fpt/esp-bt-audio/main/esp-bt-audio.kicad_pcb

## KiCad design main/esp-bt-audio.kicad_pcb (2026-11-05)

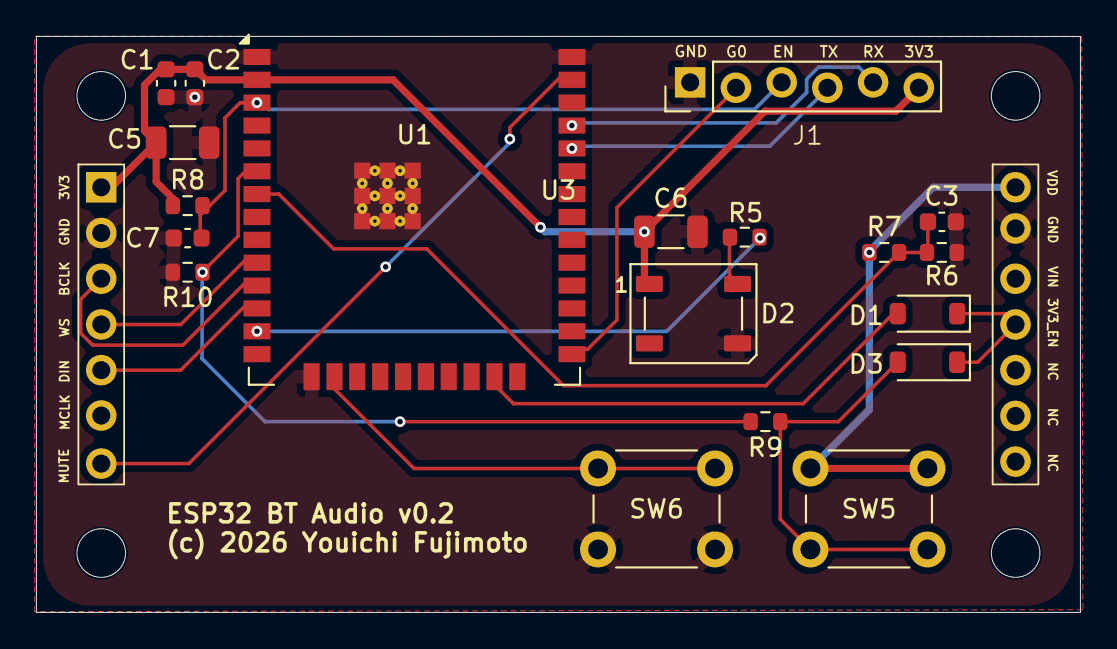
[picture p1: board esp-bt-audio.kicad_pcb from above]

Board: 2 copper layers, 58.0 x 32.0 mm, 20 parts (0 on the bottom side), 19 nets.

Parts:
C1: 10u; C_0603_1608Metric
C2, C3: 100n; C_0603_1608Metric
C5, C6: 100u; C_1206_3216Metric
C7: 1u; C_0603_1608Metric
D1, D3: 1N4148W; D_SOD-123
D2: WS2812B-V6; LED_WS2812B_PLCC4_5.0x5.0mm_P3.2mm
J1: ESPWriterJig; ESP32-Downloader_Pins
R5: 220; R_0603_1608Metric
R6, R7, R10: 100k; R_0603_1608Metric
R8: 10k; R_0603_1608Metric
R9: 22k; R_0603_1608Metric
SW5: SW_PWR1; SW_PUSH_6mm
SW6: SW_BT1; SW_PUSH_6mm
U1: ESP32-WROOM-32E
U3: github.com_fpt-I2C-Power_Module

Connections:
+3V3: C1.1, C2.1, C5.1, C6.1, D2.1 (VDD), J1.6 (3V3), R8.1, U1.2 (VDD), U3.1 (3V3)
/3V3_EN: D1.1 (K), D3.1 (K), U3.11 (3V3_EN)
/BAT_SENSE: C3.1, R6.1, R7.2, U1.7 (IO35)
/BCLK: U1.11 (IO26), U3.3 (BCLK)
/BOOT: J1.2 (G0), U1.25 (IO0)
/BTN_A1: SW6.1, U1.16 (IO13)
/DATA: U1.12 (IO27), U3.5 (DIN)
/EN: C7.1, J1.3 (EN), R8.2, U1.3 (EN)
/ESP_RX: J1.4 (TX), U1.34 (RXD0/IO3)
/ESP_TX: J1.5 (RX), U1.35 (TXD0/IO1)
/PWR_BTN: R9.2, R10.1, U1.6 (IO34)
/PWR_EN: D1.2 (A), U1.23 (IO15)
/RGB_LED: R5.1, U1.13 (IO14)
/SHUTDOWN: U1.37 (IO23), U3.7 (MUTE)
/WS: U1.10 (IO25), U3.4 (WS)
GND: C1.2, C2.2, C3.2, C5.2, C6.2, C7.2, D2.3 (VSS), J1.1 (GND), R6.2, R10.2, SW6.2, U1.1 (GND), U1.15 (GND), U1.38 (GND), U1.39 (GND), U3.2 (GND), U3.13 (GND)
unnamed: D2.4 (DIN), R5.2
unnamed: D3.2 (A), R9.1, SW5.2
VDD: R7.1, SW5.1, U3.14 (VDD)
