fpt/esp-bt-audio/i2s/i2s-power.kicad_pcb

## KiCad design i2s/i2s-power.kicad_pcb (2026-11-04)

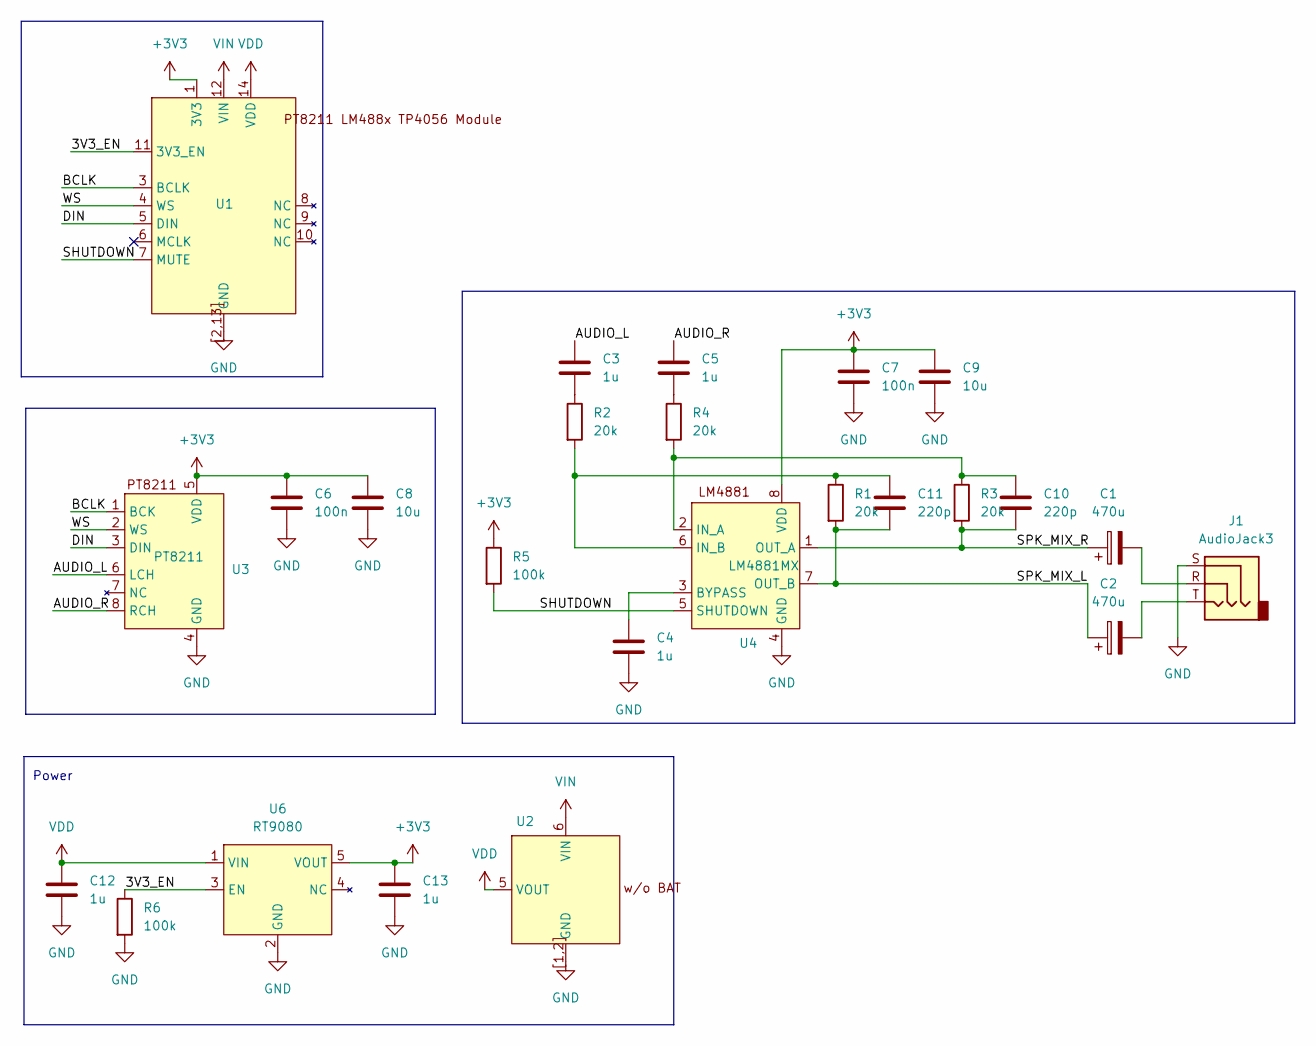
[picture p2: schematic i2s-power.kicad_sch]

Parts:
C1, C2: 470u; CP_Radial_D8.0mm_P3.50mm
C3, C4, C5, C12, C13: 1u; C_0603_1608Metric
C6, C7: 100n; C_0603_1608Metric
C8, C9: 10u; C_0603_1608Metric
C10, C11: 220p; C_0603_1608Metric
J1: AudioJack3; Jack_3.5mm_Switronic_ST-005-G_THT_Horizontal
R1, R2, R3, R4: 20k; R_0603_1608Metric
R5, R6: 100k; R_0603_1608Metric
U1: github.com_fpt-I2C-Power_Module
U2: GENERIC_TP4056_Module_wo_bat
U3: PT8211; SOP-8_3.76x4.96mm_P1.27mm; LCSC C92004
U4: LM4881MX; SO-8_3.9x4.9mm_P1.27mm
U6: RT9080; TSOT-23-5

Connections:
+3V3: C6.1, C7.1, C8.1, C9.1, C13.1, R5.1, U1.1 (3V3), U3.5 (VDD), U4.8 (VDD), U6.5 (VOUT)
/3V3_EN: R6.1, U1.11 (3V3_EN), U6.3 (EN)
/AUDIO_L: C3.1, U3.6 (LCH)
/AUDIO_R: C5.1, U3.8 (RCH)
/BCLK: U1.3 (BCLK), U3.1 (BCK)
/DIN: U1.5 (DIN), U3.3 (DIN)
/SHUTDOWN: R5.2, U1.7 (MUTE), U4.5 (SHUTDOWN)
/SPK_MIX_L: C2.1, C11.2, R1.2, U4.7 (OUT_B)
/SPK_MIX_R: C1.1, C10.2, R3.2, U4.1 (OUT_A)
/WS: U1.4 (WS), U3.2 (WS)
GND: C4.2, C6.2, C7.2, C8.2, C9.2, C12.2, C13.2, J1.S, R6.2, U1.2 (GND), U1.13 (GND), U1.[2,13] (GND), U2.1 (GND), U2.2 (GND), U2.[1,2] (GND), U3.4 (GND), U4.4 (GND), U6.2 (GND)
unnamed: C1.2, J1.R
unnamed: C2.2, J1.T
unnamed: C3.2, R2.1
unnamed: C5.2, R4.1
unnamed: C4.1, U4.3 (BYPASS)
unnamed: C10.1, R3.1, R4.2, U4.2 (IN_A)
unnamed: C11.1, R1.1, R2.2, U4.6 (IN_B)
VDD: C12.1, U1.14 (VDD), U2.5 (VOUT), U6.1 (VIN)
VIN: U1.12 (VIN), U2.6 (VIN)

Notes on the sheet:
Power

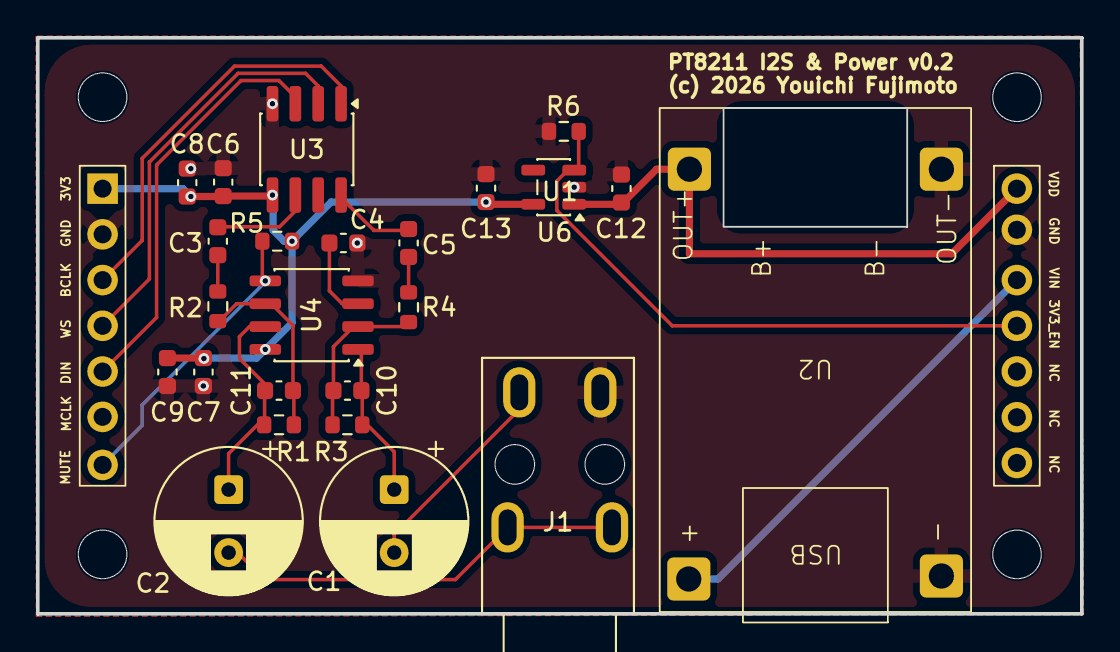
[picture p3: board i2s-power.kicad_pcb from above]

Board: 2 copper layers, 58.0 x 32.0 mm, 25 parts (0 on the bottom side), 20 nets.
