fpt/esp-bt-audio/(commit log)

2026-11-03 add pins
    [esp-bt-audio.kicad_pcb, esp-bt-audio.kicad_sch, i2s-power.kicad_pcb, i2s-power.kicad_sch]
2026-11-04 pcba first order
    [esp-bt-audio.kicad_pcb, i2s-power.kicad_pcb, i2s-power.kicad_sch]
