fpt/esp-bt-audio/(notices)

Notices in the files:
main/esp-bt-audio.kicad_pcb:
(c) 2026 Youichi Fujimoto
